linc80/Z50IOCard/README.md

# Z50IOCard

This is a simple 8-bit digital I/O card, and a demonstration of Z50Bus expansions.
The source files are made with KiCad 4.0.7.

The card dimensions, and placement of the Z50Bus connector, is in the public domain.
The remaining design is licensed under Creative Commons BY-NC-SA 4.0 with the following terms:
* Attribution — You must give appropriate credit, provide a link to the license, and indicate if changes were made. You may do so in any reasonable manner, but not in any way that suggests the licensor endorses you or your use.
* NonCommercial — You may not use the material for commercial purposes.
* ShareAlike — If you remix, transform, or build upon the material, you must distribute your contributions under the same license as the original.

For more information, see https://creativecommons.org/licenses/by-nc-sa/4.0/
