linc80/Z50IOCard/(commit log)

2018-06-14 This is the old version of the card...
    [Z50IOCard.kicad_pcb, Z50IOCard.sch]
2018-06-14 Changed from Resistor Networks to plain old resistors
    [Z50IOCard.kicad_pcb, Z50IOCard.sch]
2018-06-14 Trivial change: Bumped the revisions and updated the changed-dates
    [Z50IOCard.kicad_pcb, Z50IOCard.sch]
2018-06-28 Changed 3D models to get a proper render.
    [Z50IOCard.kicad_pcb]
2018-06-28 Moved needed external library to a shareable proper location.
    [Z50IOCard.kicad_pcb]
2018-06-28 the Footprint library table is needed to get a proper file-set.
2018-07-22 Piny fix of silk: clarify pin 1
    [Z50IOCard.kicad_pcb]
